khassounah/mormee-board-1/mormee-board-1.kicad_pcb

## KiCad design mormee-board-1.kicad_pcb (2026-02-04)

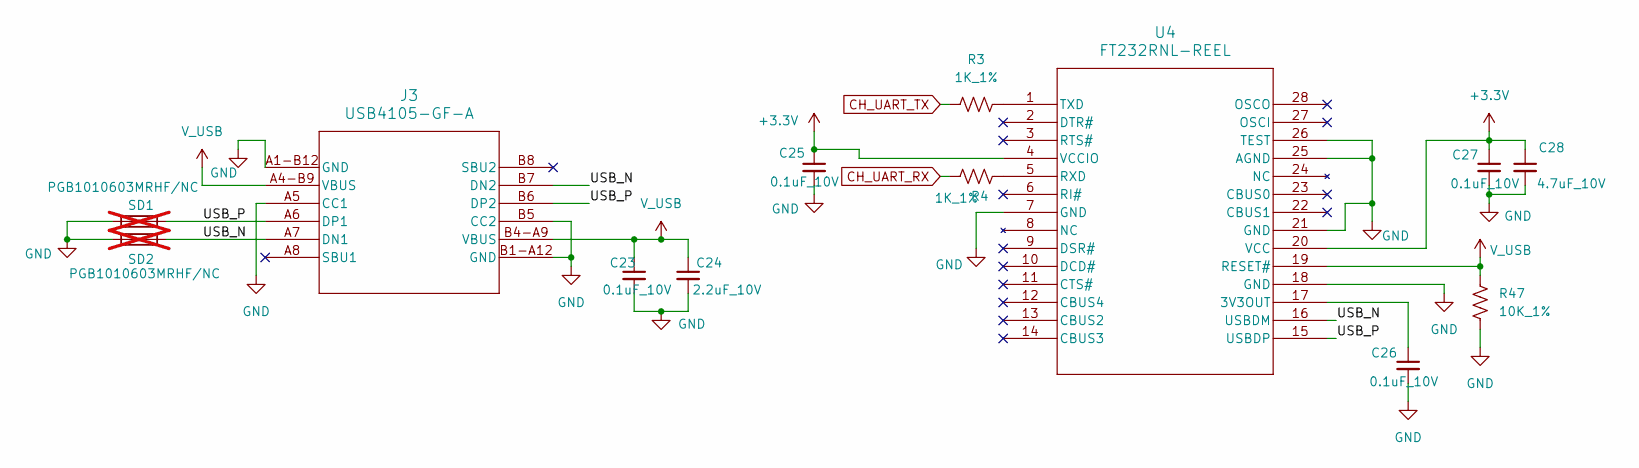
[picture p1: schematic Debug.kicad_sch]

Parts:
C23, C25, C26, C27: 0.1uF_10V; C_0603_1608Metric
C24: 2.2uF_10V; C_0603_1608Metric
C28: 4.7uF_10V; C_0603_1608Metric
J3: USB4105-GF-A; USB4105_GCT
R3, R4: 1K_1%; R_0603_1608Metric
R47: 10K_1%; R_0603_1608Metric
SD1, SD2: PGB1010603MRHF/NC; Fuse_0603_1608Metric; not fitted
U4: FT232RNL-REEL; SSOP-28_FTD

Connections:
+3.3V: C25.1, C27.1, C28.1, U4.4 (VCCIO), U4.20 (VCC); also elsewhere on the board
/Debug Interface/USB_N: J3.A7 (DN1), J3.B7 (DN2), SD2.2, U4.16 (USBDM)
/Debug Interface/USB_P: J3.A6 (DP1), J3.B6 (DP2), SD1.2, U4.15 (USBDP)
CH_UART_RX: R4.1; also elsewhere on the board
CH_UART_TX: R3.2; also elsewhere on the board
GND: C23.2, C24.2, C25.2, C26.2, C27.2, C28.2, J3.A1-B12 (GND), J3.A5 (CC1), J3.B1-A12 (GND), J3.B5 (CC2), R47.2, SD1.1, SD2.1, U4.7 (GND), U4.18 (GND), U4.21 (GND), U4.25 (AGND), U4.26 (TEST); also elsewhere on the board
unnamed: C26.1, U4.17 (3V3OUT)
unnamed: R4.2, U4.5 (RXD)
unnamed: R3.1, U4.1 (TXD)
V_USB: C23.1, C24.1, J3.A4-B9 (VBUS), J3.B4-A9 (VBUS), R47.1, U4.19 (RESET#); also elsewhere on the board

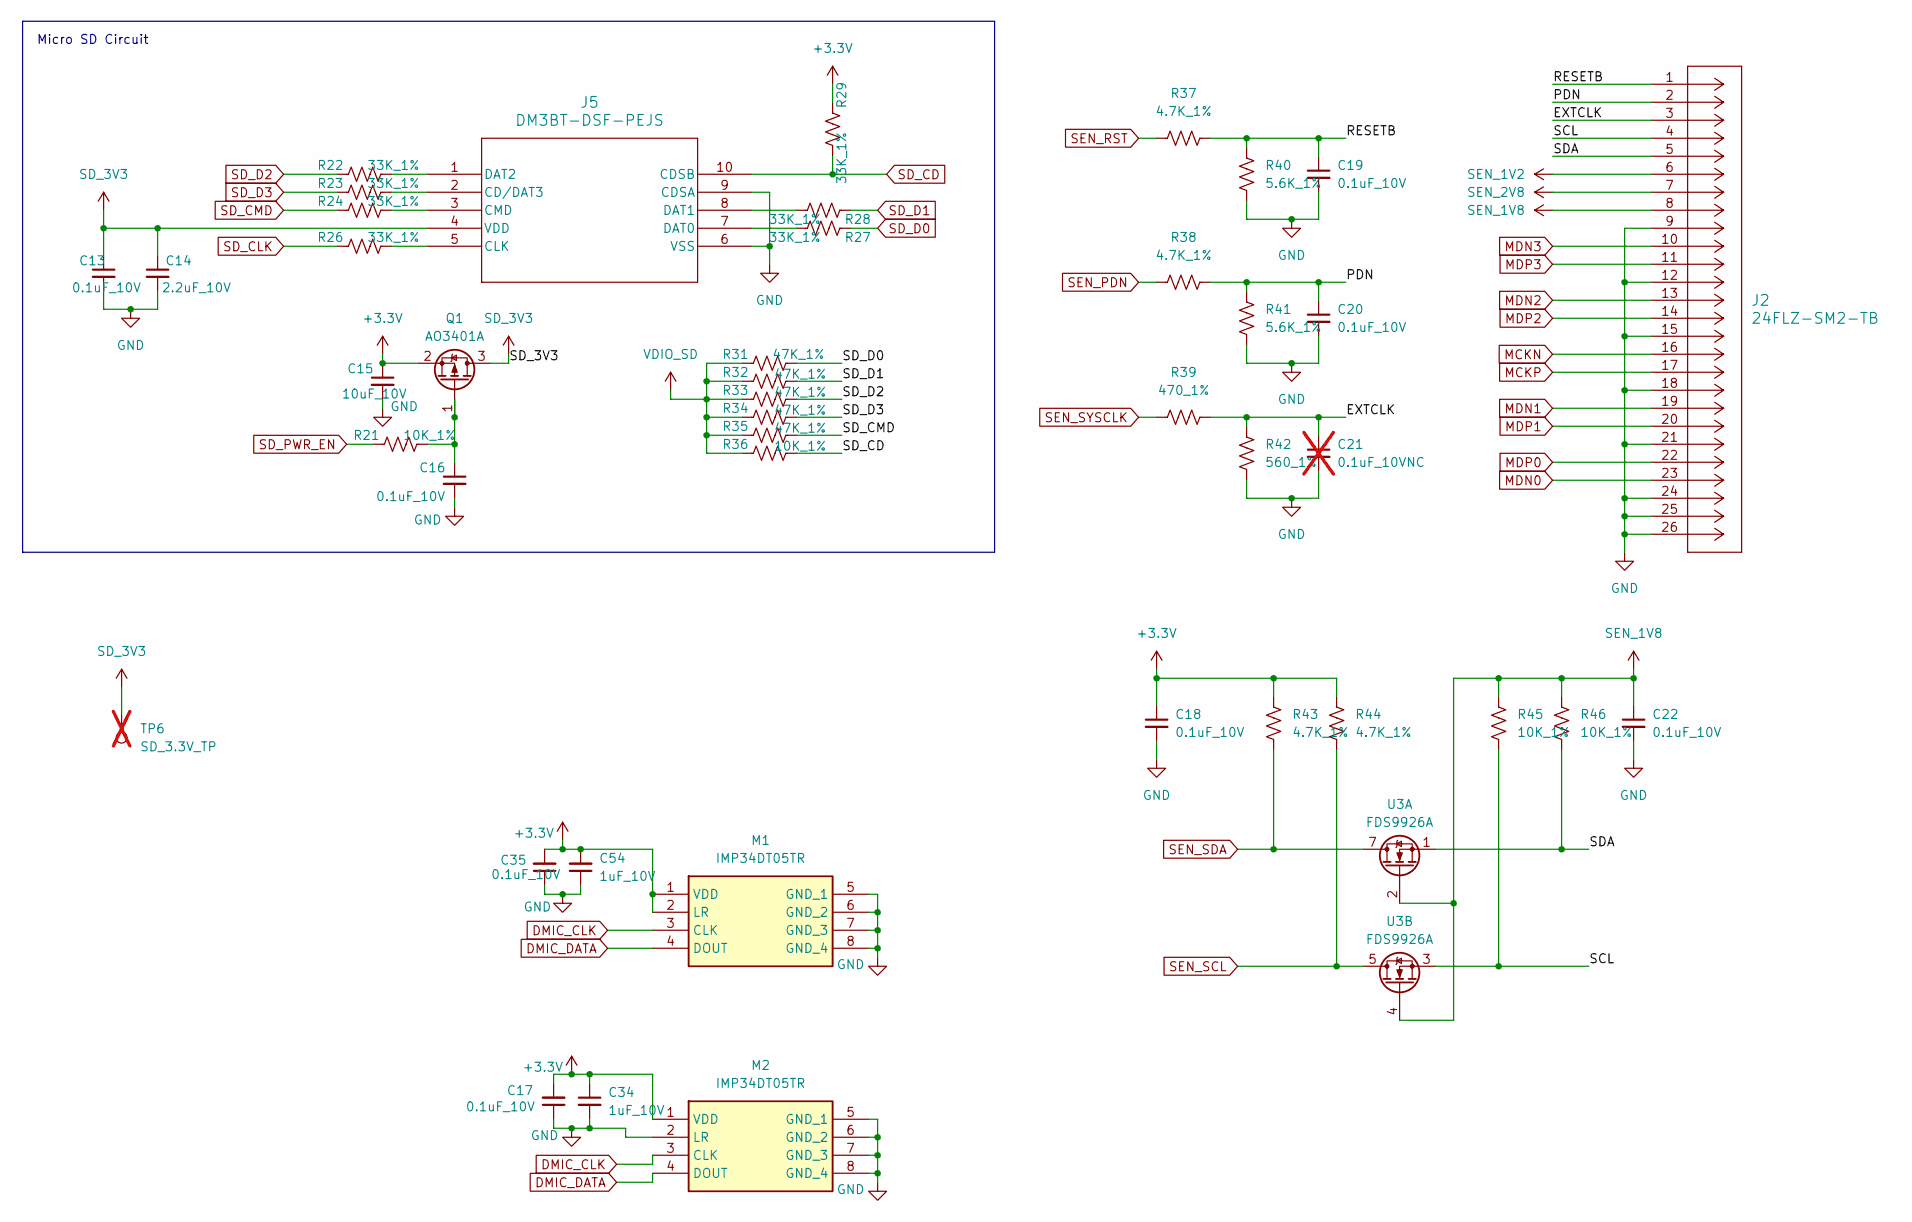
[picture p2: schematic USB.kicad_sch, SD CARD /Vidio / Audio / USB]

Parts:
C13, C16, C17, C18, C19, C20, C22, C35: 0.1uF_10V; C_0603_1608Metric
C14: 2.2uF_10V; C_0603_1608Metric
C15: 10uF_10V; C_0603_1608Metric
C21: 0.1uF_10VNC; C_0603_1608Metric; not fitted
C34, C54: 1uF_10V; C_0603_1608Metric
J2: 24FLZ-SM2-TB; CON24_1X24_DB_JST
J5: DM3BT-DSF-PEJS; DM3BT-DSF-PEJS_HIR
M1, M2: IMP34DT05TR; Manufacturer_Part_Number IMP34DT05TR; Mouser Part Number 511-IMP34DT05TR
Q1: AO3401A; SOT-23
R21, R36, R45, R46: 10K_1%; R_0603_1608Metric
R22, R23, R24, R26, R27, R28, R29: 33K_1%; R_0603_1608Metric
R31, R32, R33, R34, R35: 47K_1%; R_0603_1608Metric
R37, R38, R43, R44: 4.7K_1%; R_0603_1608Metric
R39: 470_1%; R_0603_1608Metric
R40, R41: 5.6K_1%; R_0603_1608Metric
R42: 560_1%; R_0603_1608Metric
TP6: SD_3.3V_TP; TestPoint_Pad_D1.5mm; not fitted
U3: FDS9926A; SOIC-8_3.9x4.9mm_P1.27mm

Connections:
+3.3V: C15.1, C17.2, C18.1, C34.1, C35.2, C54.2, M1.1 (VDD), M1.2 (LR), M2.1 (VDD), Q1.2 (S), R29.1, R43.1, R44.1; also elsewhere on the board
/SD CARD /Vidio / Audio / USB/EXTCLK: C21.1, J2.3, R39.1, R42.1
/SD CARD /Vidio / Audio / USB/PDN: C20.1, J2.2, R38.1, R41.1
/SD CARD /Vidio / Audio / USB/RESETB: C19.1, J2.1, R37.1, R40.1
/SD CARD /Vidio / Audio / USB/SCL: J2.4, R45.2, U3.3 (S2)
/SD CARD /Vidio / Audio / USB/SDA: J2.5, R46.2, U3.1 (S1)
DMIC_CLK: M1.3 (CLK), M2.3 (CLK); also elsewhere on the board
DMIC_DATA: M1.4 (DOUT), M2.4 (DOUT); also elsewhere on the board
GND: C13.2, C14.2, C15.2, C16.2, C17.1, C18.2, C19.2, C20.2, C21.2, C22.2, C34.2, C35.1, C54.1, J2.9, J2.12, J2.15, J2.18, J2.21, J2.24, J2.25, J2.26, J5.6 (VSS), J5.9 (CDSA), M1.5 (GND_1), M1.6 (GND_2), M1.7 (GND_3), M1.8 (GND_4), M2.2 (LR), M2.5 (GND_1), M2.6 (GND_2), M2.7 (GND_3), M2.8 (GND_4), R40.2, R41.2, R42.2; also elsewhere on the board
MCKN: J2.16; also elsewhere on the board
MCKP: J2.17; also elsewhere on the board
MDN0: J2.23; also elsewhere on the board
MDN1: J2.19; also elsewhere on the board
MDN2: J2.13; also elsewhere on the board
MDN3: J2.10; also elsewhere on the board
MDP0: J2.22; also elsewhere on the board
MDP1: J2.20; also elsewhere on the board
MDP2: J2.14; also elsewhere on the board
MDP3: J2.11; also elsewhere on the board
unnamed: J5.2 (CD/DAT3), R23.2
unnamed: J5.5 (CLK), R26.2
unnamed: J5.3 (CMD), R24.2
unnamed: J5.7 (DAT0), R27.2
unnamed: J5.8 (DAT1), R28.2
unnamed: J5.1 (DAT2), R22.2
unnamed: C16.1, Q1.1 (G), R21.2
SD_3V3: C13.1, C14.1, J5.4 (VDD), Q1.3 (D), TP6.1
SD_CD: J5.10 (CDSB), R29.2, R36.2; also elsewhere on the board
SD_CLK: R26.1; also elsewhere on the board
SD_CMD: R24.1, R35.2; also elsewhere on the board
SD_D0: R27.1, R31.2; also elsewhere on the board
SD_D1: R28.1, R32.2; also elsewhere on the board
SD_D2: R22.1, R33.2; also elsewhere on the board
SD_D3: R23.1, R34.2; also elsewhere on the board
SD_PWR_EN: R21.1; also elsewhere on the board
SEN_1V2: J2.6; also elsewhere on the board
SEN_1V8: C22.1, J2.8, R45.1, R46.1, U3.2 (G1), U3.4 (G2); also elsewhere on the board
SEN_2V8: J2.7; also elsewhere on the board
SEN_PDN: R38.2; also elsewhere on the board
SEN_RST: R37.2; also elsewhere on the board
SEN_SCL: R44.2, U3.5 (D2), U3.6 (D2); also elsewhere on the board
SEN_SDA: R43.2, U3.7 (D1), U3.8 (D1); also elsewhere on the board
SEN_SYSCLK: R39.2; also elsewhere on the board
VDIO_SD: R31.1, R32.1, R33.1, R34.1, R35.1, R36.1; also elsewhere on the board

Notes on the sheet:
Micro SD Circuit

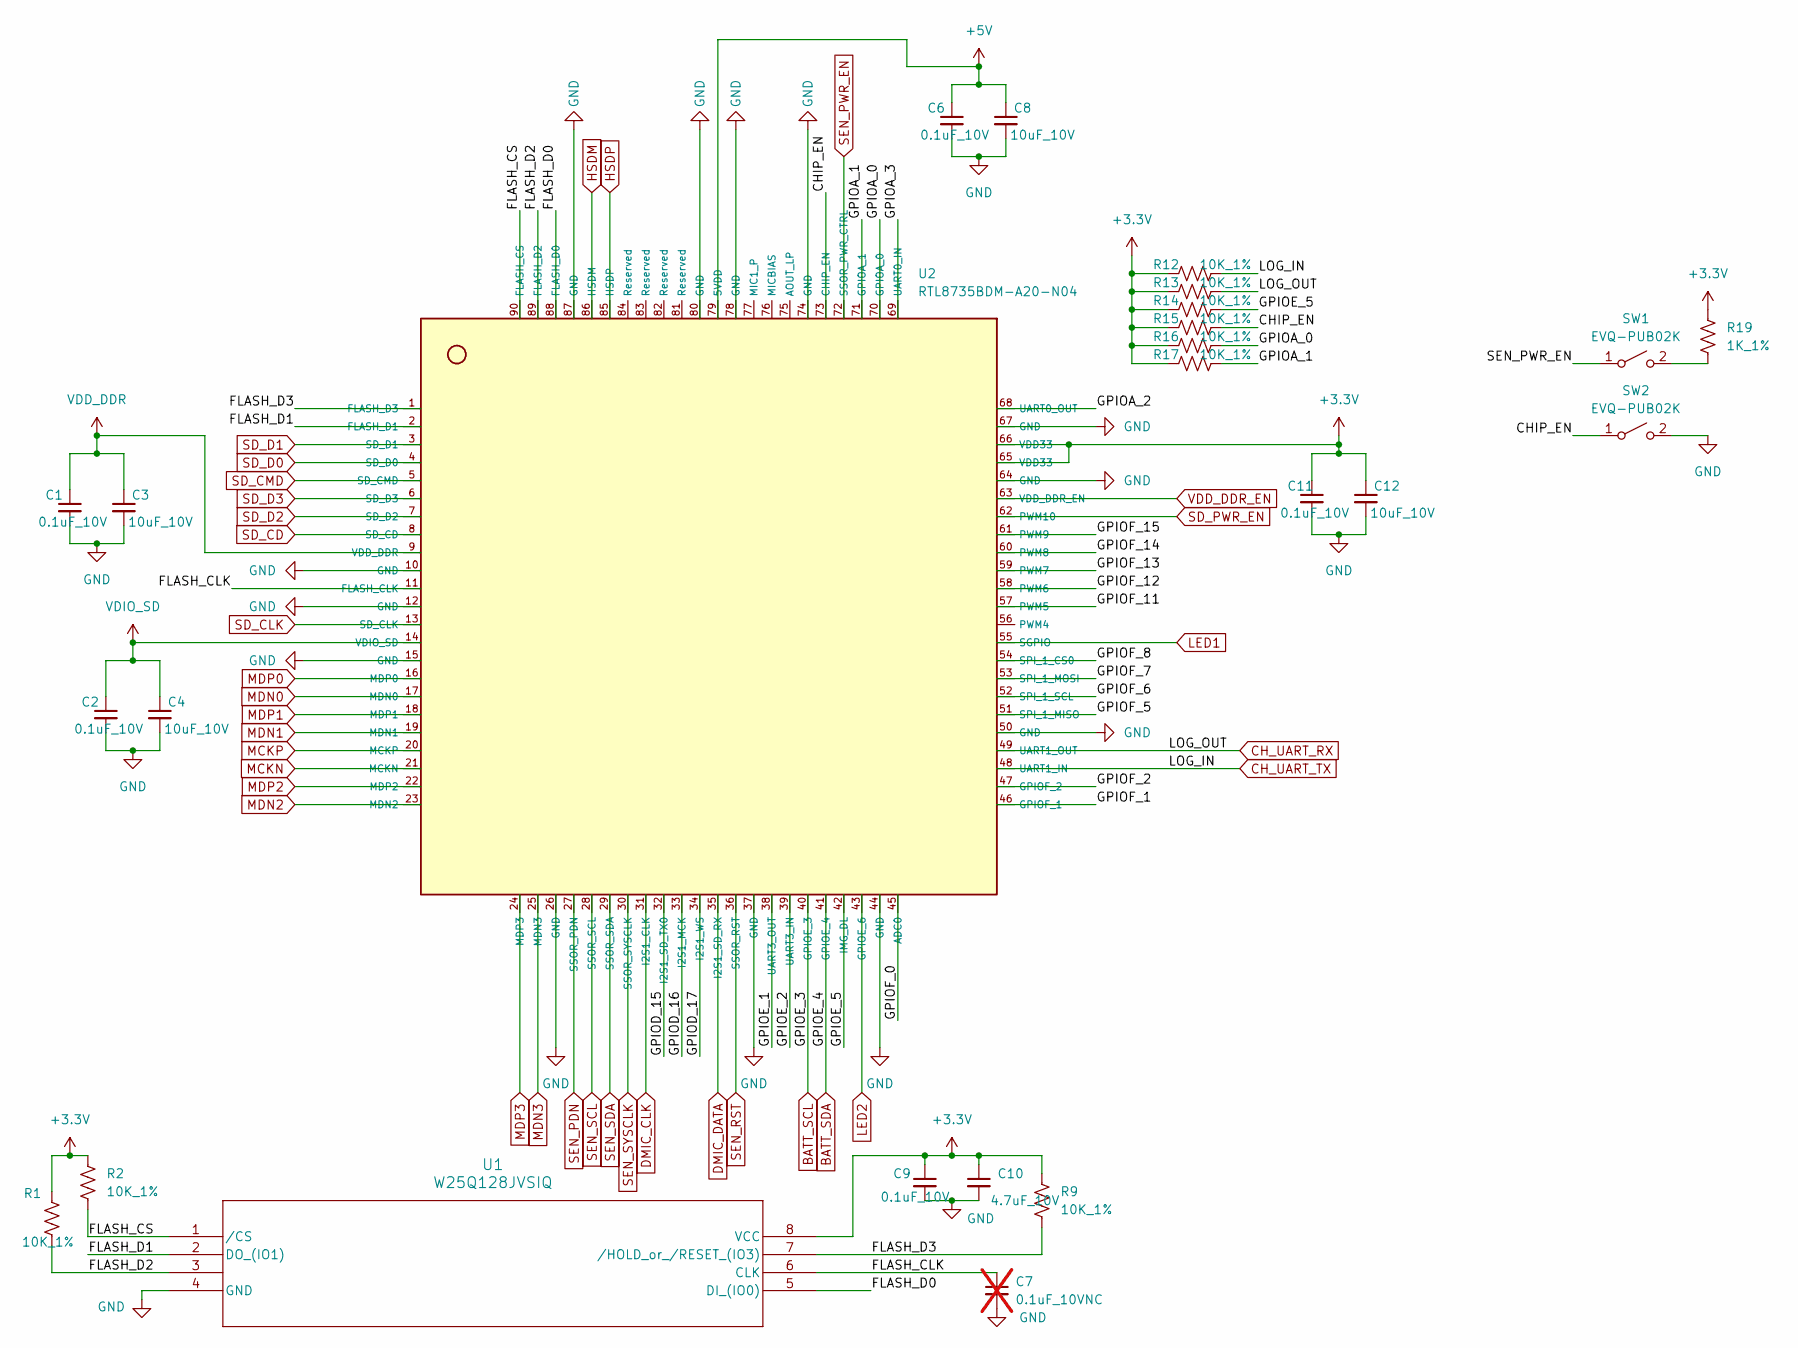
[picture p3: schematic RTL8735B.kicad_sch]

Parts:
C1, C2, C6, C9, C11: 0.1uF_10V; C_0603_1608Metric
C3, C4, C8, C12: 10uF_10V; C_0603_1608Metric
C7: 0.1uF_10VNC; C_0603_1608Metric; not fitted
C10: 4.7uF_10V; C_0603_1608Metric
R1, R2, R9, R12, R13, R14, R15, R16, R17: 10K_1%; R_0603_1608Metric
R19: 1K_1%; R_0603_1608Metric
SW1, SW2: EVQ-PUB02K; Panasonic_EVQPUK_EVQPUB
U1: W25Q128JVSIQ; SOIC_128JVSIQ_WIN
U2: RTL8735BDM-A20-N04

Connections:
+3.3V: C9.1, C10.1, C11.1, C12.1, R1.1, R2.1, R9.1, R12.1, R13.1, R14.1, R15.1, R16.1, R17.1, R19.1, U1.8 (VCC), U2.65 (VDD33), U2.66 (VDD33); also elsewhere on the board
+5V: C6.1, C8.1, U2.79 (5VDD); also elsewhere on the board
/RTL9835B/CHIP_EN: R15.2, SW2.1 (A), U2.73 (CHIP_EN)
/RTL9835B/FLASH_CLK: C7.1, U1.6 (CLK), U2.11 (FLASH_CLK)
/RTL9835B/FLASH_CS: R2.2, U1.1 (/CS), U2.90 (FLASH_CS)
/RTL9835B/FLASH_D0: U1.5 (DI_(IO0)), U2.88 (FLASH_D0)
/RTL9835B/FLASH_D1: U1.2 (DO_(IO1)), U2.2 (FLASH_D1)
/RTL9835B/FLASH_D2: R1.2, U1.3, U2.89 (FLASH_D2)
/RTL9835B/FLASH_D3: R9.2, U1.7 (/HOLD_or_/RESET_(IO3)), U2.1 (FLASH_D3)
/RTL9835B/GPIOA_0: R16.2, U2.70 (GPIOA_0)
/RTL9835B/GPIOA_1: R17.2, U2.71 (GPIOA_1)
/RTL9835B/GPIOA_2: U2.68 (UART0_OUT)
/RTL9835B/GPIOA_3: U2.69 (UART0_IN)
/RTL9835B/GPIOD_15: U2.32 (I2S1_SD_TX0)
/RTL9835B/GPIOD_16: U2.33 (I2S1_MCK)
/RTL9835B/GPIOD_17: U2.34 (I2S1_WS)
/RTL9835B/GPIOE_1: U2.38 (UART3_OUT)
/RTL9835B/GPIOE_2: U2.39 (UART3_IN)
/RTL9835B/GPIOE_5: R14.2, U2.42 (IMG_DL)
/RTL9835B/GPIOF_0: U2.45 (ADC0)
/RTL9835B/GPIOF_1: U2.46 (GPIOF_1)
/RTL9835B/GPIOF_2: U2.47 (GPIOF_2)
/RTL9835B/GPIOF_5: U2.51 (SPI_1_MISO)
/RTL9835B/GPIOF_6: U2.52 (SPI_1_SCL)
/RTL9835B/GPIOF_7: U2.53 (SPI_1_MOSI)
/RTL9835B/GPIOF_8: U2.54 (SPI_1_CS0)
/RTL9835B/GPIOF_11: U2.57 (PWM5)
/RTL9835B/GPIOF_12: U2.58 (PWM6)
/RTL9835B/GPIOF_13: U2.59 (PWM7)
/RTL9835B/GPIOF_14: U2.60 (PWM8)
/RTL9835B/GPIOF_15: U2.61 (PWM9)
BATT_SCL: U2.40 (GPIOE_3); also elsewhere on the board
BATT_SDA: U2.41 (GPIOE_4); also elsewhere on the board
CH_UART_RX: R13.2, U2.49 (UART1_OUT); also elsewhere on the board
CH_UART_TX: R12.2, U2.48 (UART1_IN); also elsewhere on the board
DMIC_CLK: U2.31 (I2S1_CLK); also elsewhere on the board
DMIC_DATA: U2.35 (I2S1_SD_RX); also elsewhere on the board
GND: C1.2, C2.2, C3.2, C4.2, C6.2, C7.2, C8.2, C9.2, C10.2, C11.2, C12.2, SW2.2 (B), U1.4 (GND), U2.10 (GND), U2.12 (GND), U2.15 (GND), U2.26 (GND), U2.37 (GND), U2.44 (GND), U2.50 (GND), U2.64 (GND), U2.67 (GND), U2.74 (GND), U2.78 (GND), U2.80 (GND), U2.87 (GND); also elsewhere on the board
HSDM: U2.86 (HSDM)
HSDP: U2.85 (HSDP)
LED1: U2.55 (SGPIO)
LED2: U2.43 (GPIOE_6)
MCKN: U2.21 (MCKN); also elsewhere on the board
MCKP: U2.20 (MCKP); also elsewhere on the board
MDN0: U2.17 (MDN0); also elsewhere on the board
MDN1: U2.19 (MDN1); also elsewhere on the board
MDN2: U2.23 (MDN2); also elsewhere on the board
MDN3: U2.25 (MDN3); also elsewhere on the board
MDP0: U2.16 (MDP0); also elsewhere on the board
MDP1: U2.18 (MDP1); also elsewhere on the board
MDP2: U2.22 (MDP2); also elsewhere on the board
MDP3: U2.24 (MDP3); also elsewhere on the board
unnamed: R19.2, SW1.2 (B)
SD_CD: U2.8 (SD_CD); also elsewhere on the board
SD_CLK: U2.13 (SD_CLK); also elsewhere on the board
SD_CMD: U2.5 (SD_CMD); also elsewhere on the board
SD_D0: U2.4 (SD_D0); also elsewhere on the board
SD_D1: U2.3 (SD_D1); also elsewhere on the board
SD_D2: U2.7 (SD_D2); also elsewhere on the board
SD_D3: U2.6 (SD_D3); also elsewhere on the board
SD_PWR_EN: U2.62 (PWM10); also elsewhere on the board
SEN_PDN: U2.27 (SSOR_PDN); also elsewhere on the board
SEN_PWR_EN: SW1.1 (A), U2.72 (SSOR_PWR_CTRL); also elsewhere on the board
SEN_RST: U2.36 (SSOR_RST); also elsewhere on the board
SEN_SCL: U2.28 (SSOR_SCL); also elsewhere on the board
SEN_SDA: U2.29 (SSOR_SDA); also elsewhere on the board
SEN_SYSCLK: U2.30 (SSOR_SYSCLK); also elsewhere on the board
VDD_DDR: C1.1, C3.1, U2.9 (VDD_DDR); also elsewhere on the board
VDD_DDR_EN: U2.63 (VDD_DDR_EN); also elsewhere on the board
VDIO_SD: C2.1, C4.1, U2.14 (VDIO_SD); also elsewhere on the board

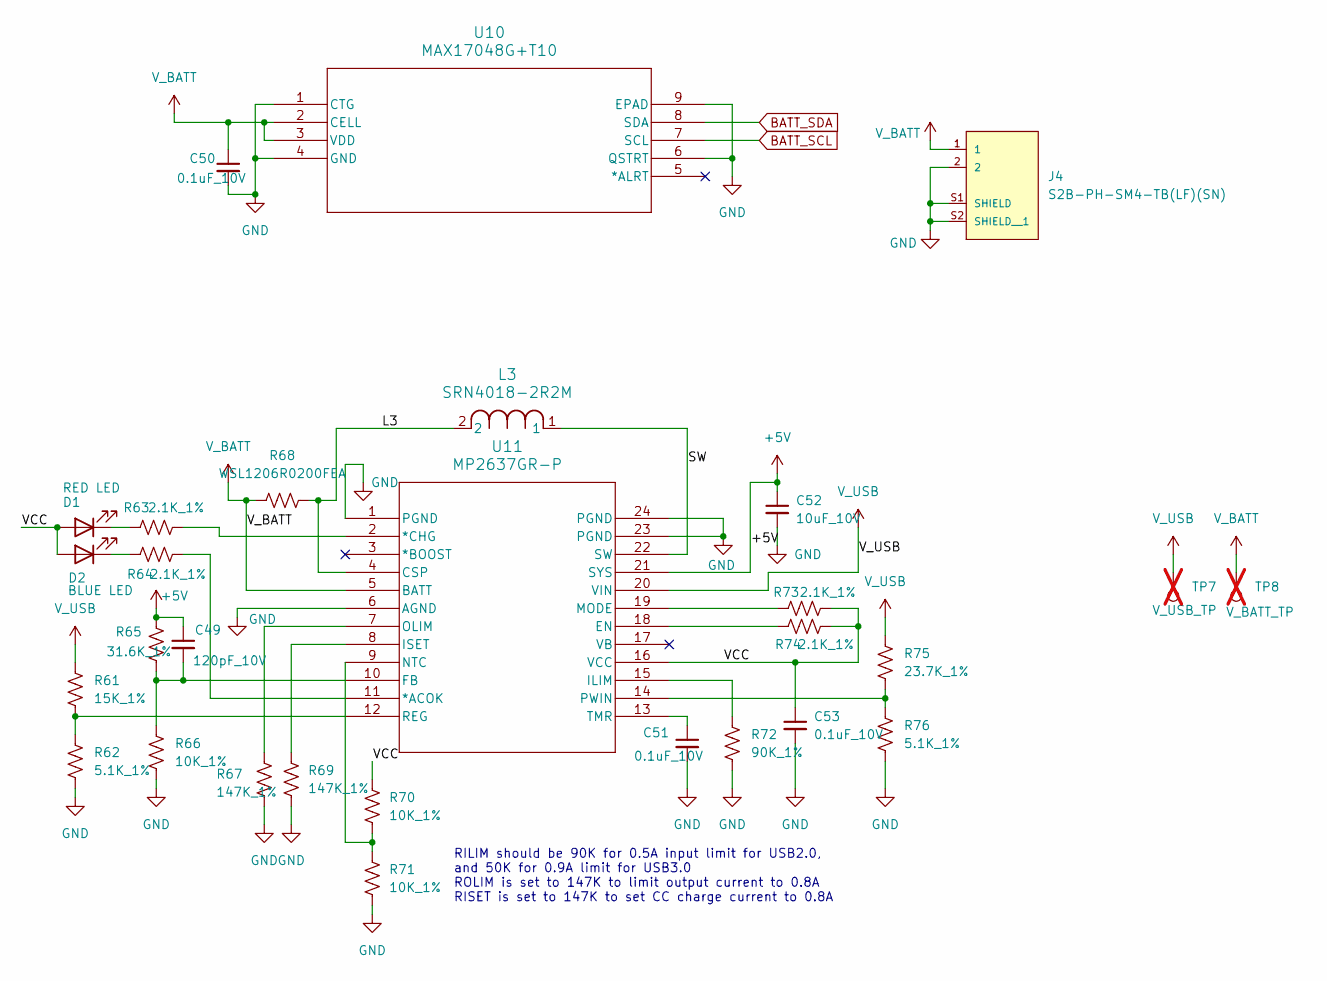
[picture p4: schematic battery.kicad_sch]

Parts:
C49: 120pF_10V; C_0603_1608Metric
C50, C51, C53: 0.1uF_10V; C_0603_1608Metric
C52: 10uF_10V; C_0603_1608Metric
D1: RED LED; LED_0603_1608Metric
D2: BLUE LED; LED_0603_1608Metric
J4: S2B-PH-SM4-TB(LF)(SN); JST_S2B-PH-SM4-TB_LF__SN_
L3: SRN4018-2R2M; IND_BOURNS_SRN4018
R61: 15K_1%; R_0603_1608Metric
R62, R76: 5.1K_1%; R_0603_1608Metric
R63, R64, R73, R74: 2.1K_1%; R_0603_1608Metric
R65: 31.6K_1%; R_0603_1608Metric
R66, R70, R71: 10K_1%; R_0603_1608Metric
R67, R69: 147K_1%; R_0603_1608Metric
R68: WSL1206R0200FEA; R_1206_3216Metric
R72: 90K_1%; R_0603_1608Metric
R75: 23.7K_1%; R_0603_1608Metric
TP7: V_USB_TP; TestPoint_Pad_D1.5mm; not fitted
TP8: V_BATT_TP; TestPoint_Pad_D1.5mm; not fitted
U10: MAX17048G+T10; 21-0168E_T822-3_MXM
U11: MP2637GR-P; QFN-24_MP2637_MNP

Connections:
+5V: C49.1, C52.1, R65.1, U11.21 (SYS); also elsewhere on the board
/Battery/L3: L3.2, R68.2, U11.4 (CSP)
/Battery/SW: L3.1, U11.22 (SW)
/Battery/VCC: C53.1, D1.2 (A), D2.2 (A), R70.1, R73.1, R74.2, U11.16 (VCC)
BATT_SCL: U10.7 (SCL); also elsewhere on the board
BATT_SDA: U10.8 (SDA); also elsewhere on the board
GND: C50.2, C51.2, C52.2, C53.2, J4.2, J4.S1 (SHIELD), J4.S2 (SHIELD__1), R62.2, R66.2, R67.2, R69.2, R71.2, R72.2, R76.2, U10.1 (CTG), U10.4 (GND), U10.6 (QSTRT), U10.9 (EPAD), U11.1 (PGND), U11.6 (AGND), U11.23 (PGND), U11.24 (PGND); also elsewhere on the board
unnamed: D1.1 (K), R63.1
unnamed: D2.1 (K), R64.1
unnamed: R64.2, U11.11 (*ACOK)
unnamed: R63.2, U11.2 (*CHG)
unnamed: R74.1, U11.18 (EN)
unnamed: C49.2, R65.2, R66.1, U11.10 (FB)
unnamed: R72.1, U11.15 (ILIM)
unnamed: R69.1, U11.8 (ISET)
unnamed: R73.2, U11.19 (MODE)
unnamed: R70.2, R71.1, U11.9 (NTC)
unnamed: R67.1, U11.7 (OLIM)
unnamed: R75.2, R76.1, U11.14 (PWIN)
unnamed: R61.2, R62.1, U11.12 (REG)
unnamed: C51.1, U11.13 (TMR)
V_BATT: C50.1, J4.1, R68.1, TP8.1, U10.2 (CELL), U10.3 (VDD), U11.5 (BATT)
V_USB: R61.1, R75.1, TP7.1, U11.20 (VIN); also elsewhere on the board

Notes on the sheet:
RILIM should be 90K for 0.5A input limit for USB2.0, and 50K for 0.9A limit for USB3.0 ROLIM is set to 147K to limit output current to 0.8A RISET is set to 147K to set CC charge current to 0.8A

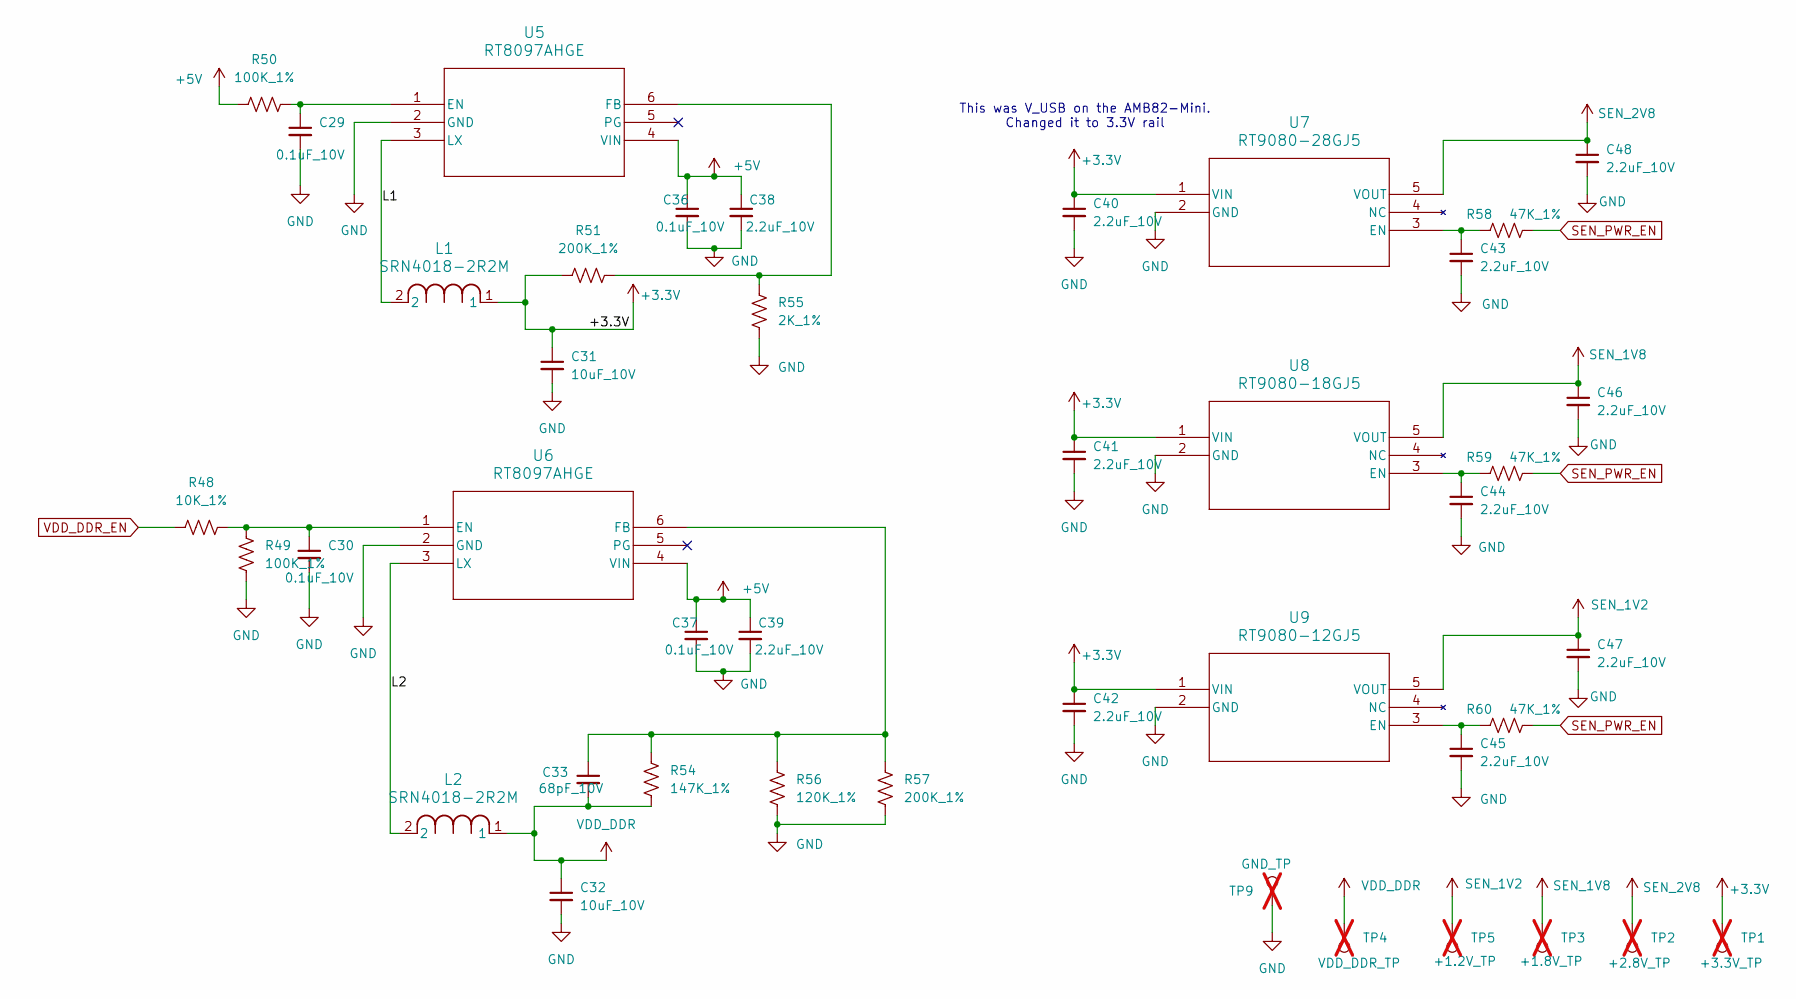
[picture p5: schematic power.kicad_sch]

Parts:
C29, C30, C36, C37: 0.1uF_10V; C_0603_1608Metric
C31, C32: 10uF_10V; C_0603_1608Metric
C33: 68pF_10V; C_0603_1608Metric
C38, C39, C40, C41, C42, C43, C44, C45, C46, C47, C48: 2.2uF_10V; C_0603_1608Metric
L1, L2: SRN4018-2R2M; IND_BOURNS_SRN4018
R48: 10K_1%; R_0603_1608Metric
R49, R50: 100K_1%; R_0603_1608Metric
R51, R57: 200K_1%; R_0603_1608Metric
R54: 147K_1%; R_0603_1608Metric
R55: 2K_1%; R_0603_1608Metric
R56: 120K_1%; R_0603_1608Metric
R58, R59, R60: 47K_1%; R_0603_1608Metric
TP1: +3.3V_TP; TestPoint_Pad_D1.5mm; not fitted
TP2: +2.8V_TP; TestPoint_Pad_D1.5mm; not fitted
TP3: +1.8V_TP; TestPoint_Pad_D1.5mm; not fitted
TP4: VDD_DDR_TP; TestPoint_Pad_D1.5mm; not fitted
TP5: +1.2V_TP; TestPoint_Pad_D1.5mm; not fitted
TP9: GND_TP; TestPoint_Pad_D1.5mm; not fitted
U5, U6: RT8097AHGE; SOT-23-6_Handsoldering
U7: RT9080-28GJ5; TSOT-23-5_RIT
U8: RT9080-18GJ5; TSOT-23-5_RIT
U9: RT9080-12GJ5; TSOT-23-5_RIT

Connections:
+3.3V: C31.1, C40.1, C41.1, C42.1, L1.1, R51.1, TP1.1, U7.1 (VIN), U8.1 (VIN), U9.1 (VIN); also elsewhere on the board
+5V: C36.1, C37.1, C38.1, C39.1, R50.1, U5.4 (VIN), U6.4 (VIN); also elsewhere on the board
/Power/L1: L1.2, U5.3 (LX)
/Power/L2: L2.2, U6.3 (LX)
GND: C29.2, C30.2, C31.2, C32.2, C36.2, C37.2, C38.2, C39.2, C40.2, C41.2, C42.2, C43.2, C44.2, C45.2, C46.2, C47.2, C48.2, R49.1, R55.2, R56.2, R57.2, TP9.1, U5.2 (GND), U6.2 (GND), U7.2 (GND), U8.2 (GND), U9.2 (GND); also elsewhere on the board
unnamed: C29.1, R50.2, U5.1 (EN)
unnamed: R51.2, R55.1, U5.6 (FB)
unnamed: C30.1, R48.2, R49.2, U6.1 (EN)
unnamed: C33.1, R54.2, R56.1, R57.1, U6.6 (FB)
unnamed: C43.1, R58.1, U7.3 (EN)
unnamed: C44.1, R59.1, U8.3 (EN)
unnamed: C45.1, R60.1, U9.3 (EN)
SEN_1V2: C47.1, TP5.1, U9.5 (VOUT); also elsewhere on the board
SEN_1V8: C46.1, TP3.1, U8.5 (VOUT); also elsewhere on the board
SEN_2V8: C48.1, TP2.1, U7.5 (VOUT); also elsewhere on the board
SEN_PWR_EN: R58.2, R59.2, R60.2; also elsewhere on the board
VDD_DDR: C32.1, C33.2, L2.1, R54.1, TP4.1; also elsewhere on the board
VDD_DDR_EN: R48.1; also elsewhere on the board

Notes on the sheet:
This was V_USB on the AMB82-Mini. Changed it to 3.3V rail

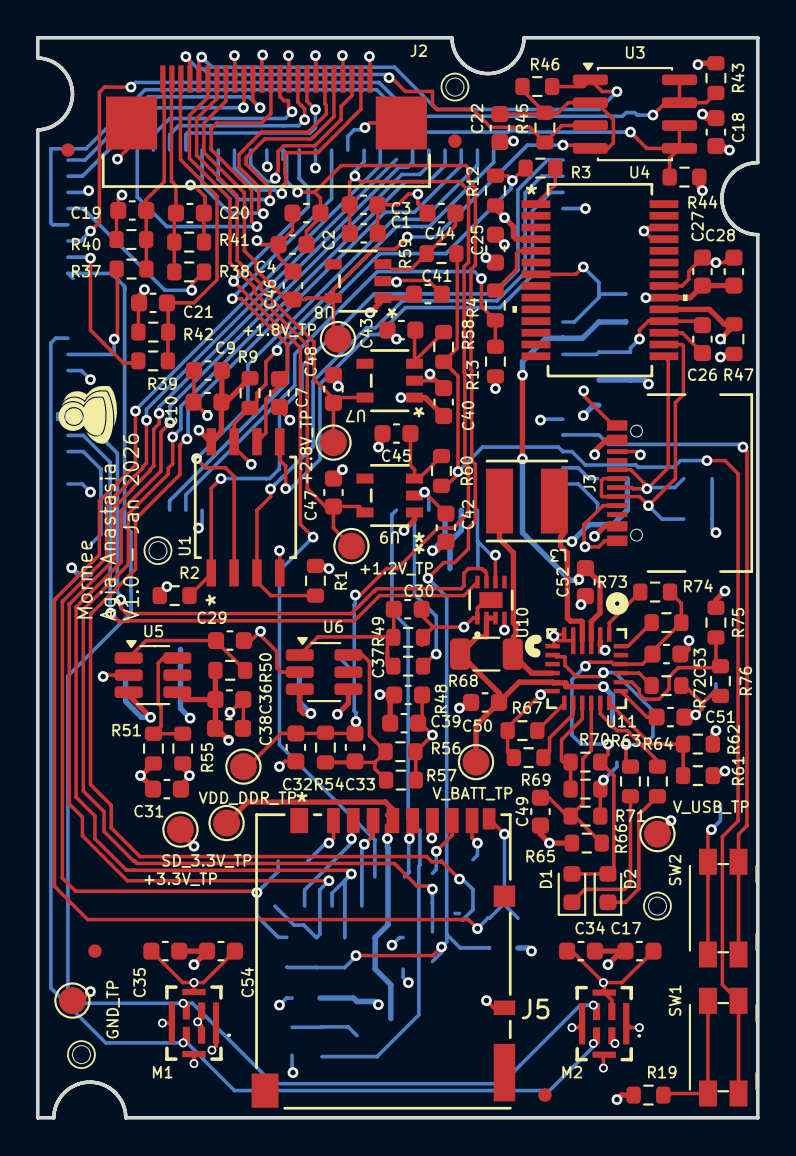
[picture p6: board mormee-board-1.kicad_pcb from above]

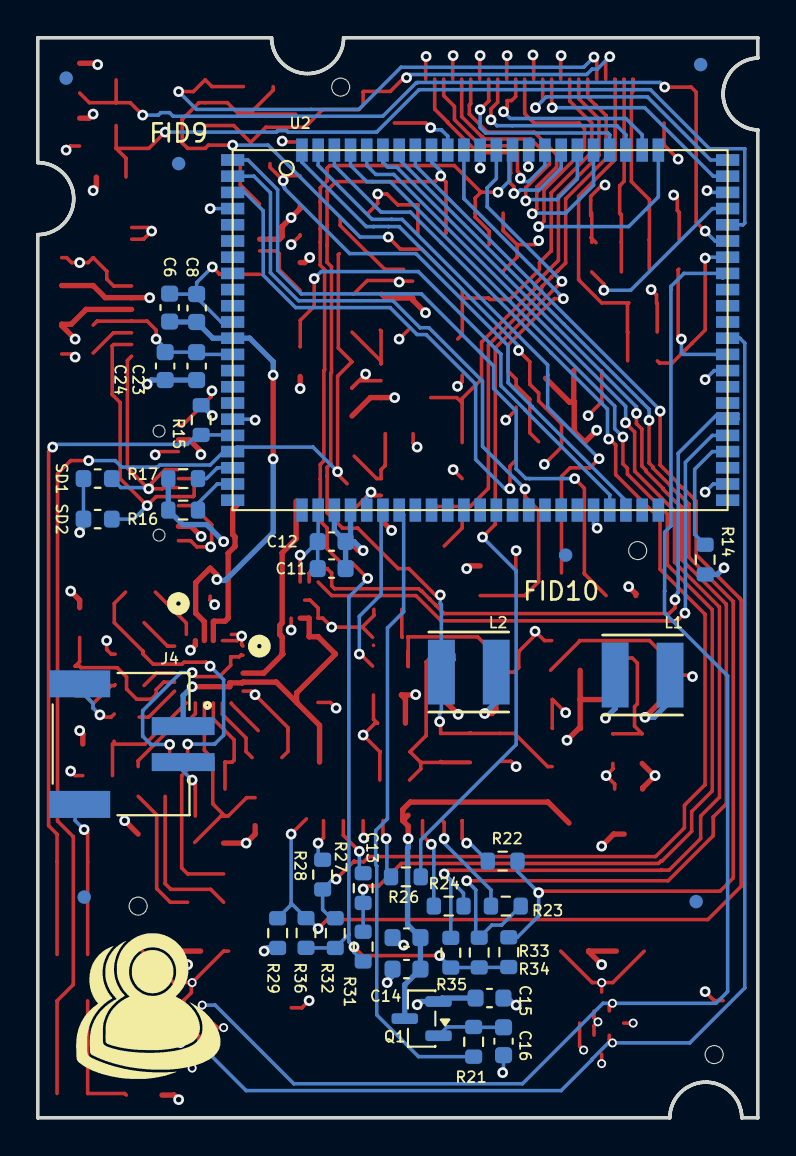
[picture p7: board mormee-board-1.kicad_pcb from below]

Board: 4 copper layers, 40.0 x 60.0 mm, 167 parts (41 on the bottom side), 96 nets.

Other parts of the board:
FID1, FID2, FID3, FID4, FID5, FID6, FID7, FID8, FID9, FID10: Fiducial; Fiducial_0.75mm_Mask1.5mm
H1, H2, H3, H4: MountingHole; MountingHole_1mm
