khassounah/mormee-board-1/(commit log)

2026-01-15 All key features are in the schematic.
    [RTL8735B.kicad_sch, USB.kicad_sch, battery.kicad_sch, mormee-board-1.kicad_sch, power.kicad_sch]
2026-01-21 All footprints configured correctly. Next step is layout
    [Debug.kicad_sch, RTL8735B.kicad_sch, USB.kicad_sch, battery.kicad_sch, mormee-board-1.kicad_pcb, power.kicad_sch]
2026-01-24 In the middle of layout. WIP
    [Debug.kicad_sch, RTL8735B.kicad_sch, USB.kicad_sch, battery.kicad_sch, mormee-board-1.kicad_pcb, power.kicad_sch]
2026-01-30 Breakthrough in PCB layout. WIP
    [RTL8735B.kicad_sch, USB.kicad_sch, battery.kicad_sch, mormee-board-1.kicad_pcb, power.kicad_sch]
2026-01-31 Most signals routed. Just need power plane clean up and final checks. Almost there, but WIP
    [RTL8735B.kicad_sch, mormee-board-1.kicad_pcb]
2026-01-31 All nets seem to be routed. Checkingo
    [mormee-board-1.kicad_pcb]
2026-02-01 Board is fully routed
    [battery.kicad_sch, mormee-board-1.kicad_pcb]
2026-02-01 Added text and logo
    [mormee-board-1.kicad_pcb]
2026-02-01 I think I'm done. Fingers crossed.
    [USB.kicad_sch, mormee-board-1.kicad_pcb]
2026-02-02 Added mounting holes and alignment notches
    [mormee-board-1.kicad_pcb]
2026-02-02 Ready. I think. At last. Probably.
    [mormee-board-1.kicad_pcb]
2026-02-02 Now v1.0 is complete
    [mormee-board-1.kicad_pcb]
2026-02-02 Added 1k resistors in series with the FTDI Tx & Rx lines. This was recommended by Gemini to protect when the VCC is unpowered to the FTDI chip, and we're running from battery.
    [Debug.kicad_sch, mormee-board-1.kicad_pcb]
2026-02-02 Updated gerbers for official v1.0
2026-02-03 Replaced all passive footprints from 0603 metric to 0603 imperial. Big oversight. All done. Next is DRC
    [Debug.kicad_sch, RTL8735B.kicad_sch, USB.kicad_sch, battery.kicad_sch, mormee-board-1.kicad_pcb, power.kicad_sch]
2026-02-03 All footprints are humanly visible (using imperial 0603), no meaningful DRC issues, and looking good.
    [mormee-board-1.kicad_pcb]
2026-02-03 All fiducials and mounting holes placed. Except one hole, which I'll try to place. WIP
    [Debug.kicad_sch, RTL8735B.kicad_sch, USB.kicad_sch, battery.kicad_sch, mormee-board-1.kicad_pcb, mormee-board-1.kicad_sch, power.kicad_sch]
2026-02-03 This should be it. Gerber files with drill files generated.
    [mormee-board-1.kicad_pcb]
2026-02-03 Updated LED footprint to 0603, which was easier to find
    [battery.kicad_sch, mormee-board-1.kicad_pcb]
2026-02-03 Fixed R55 value
    [power.kicad_sch]
2026-02-04 Updated USB connector pads to be manufacturable
    [mormee-board-1.kicad_pcb]
2026-02-04 Final final gerbers
2026-02-04 Renamed markers file
    [markers.kicad_sch, mormee-board-1.kicad_sch]
